Zilch123/CMC-Spiro/CMC_Spiro.STL

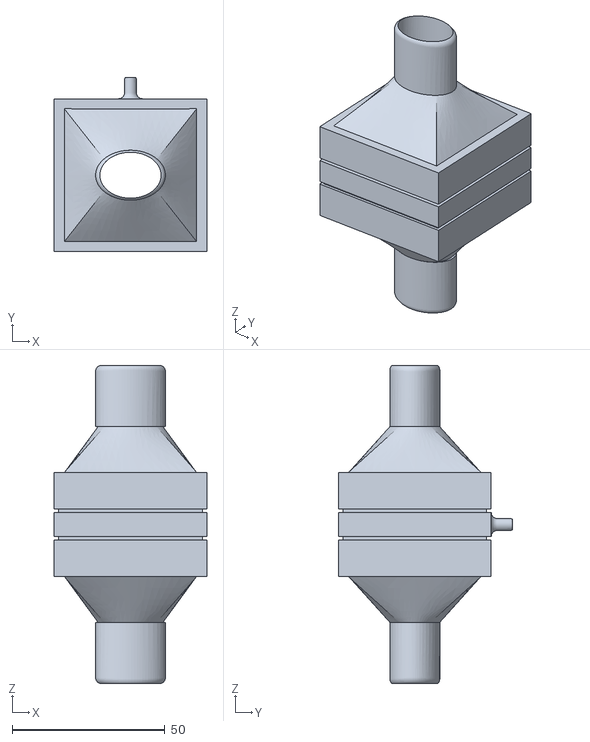
[picture p5: CAD file, 2020-10-22]
CMC_Spiro.STL
50.0 x 57.0 x 104.0
