Zilch123/CMC-Spiro/magesh_CMCSpiro.step

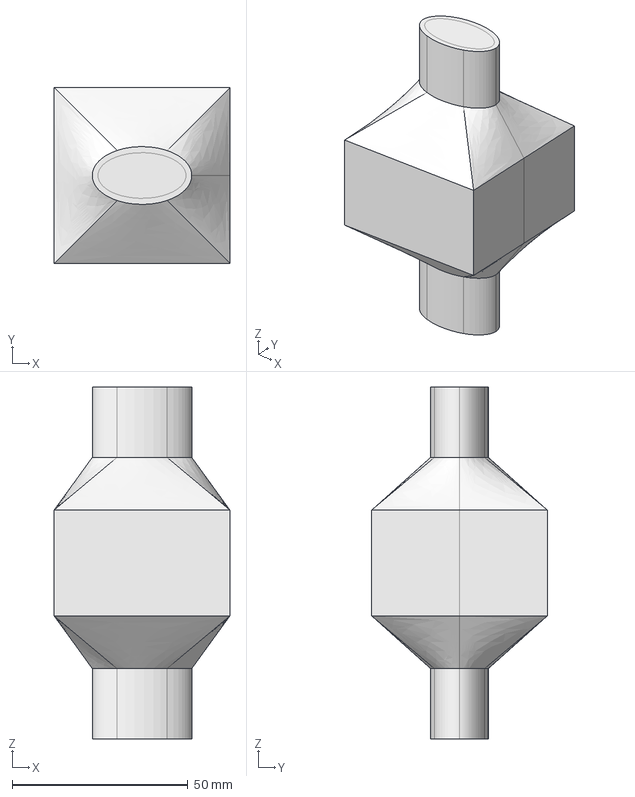
[picture p6: CAD file, 2020-10-22]
magesh_CMCSpiro.step
50.0 x 50.0 x 100.0 mm
